kliment/reup/board.png

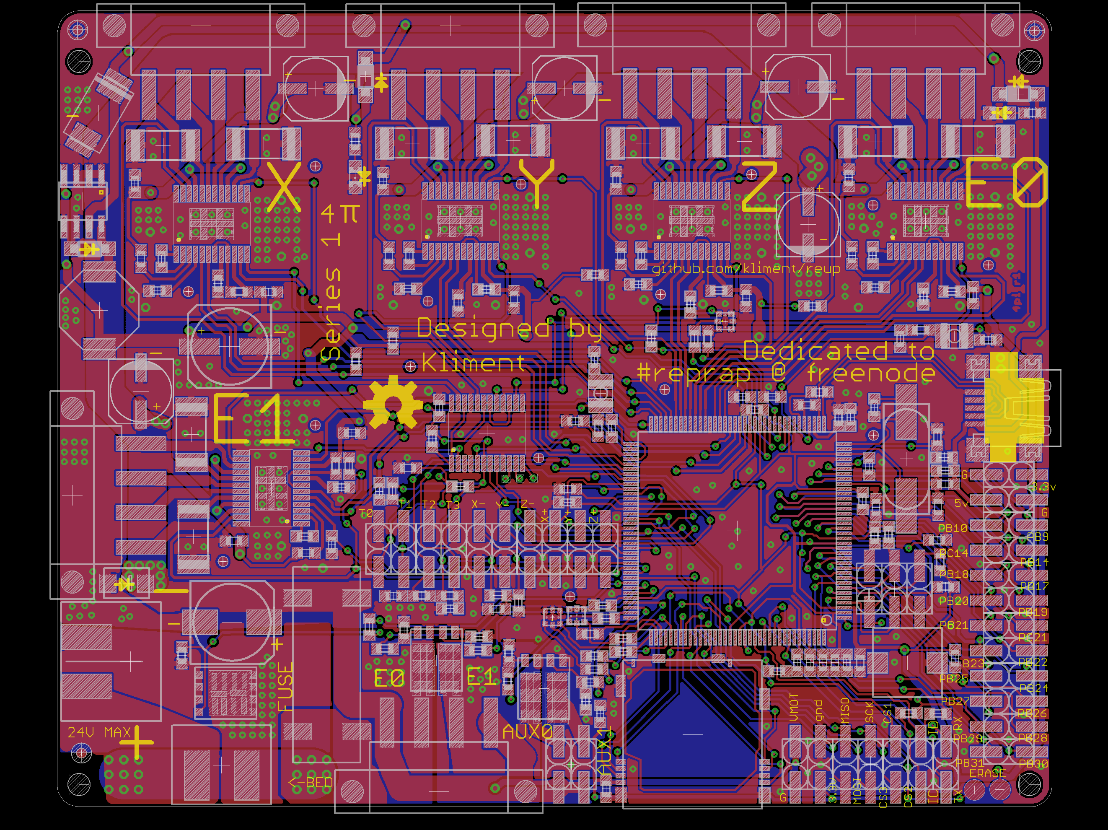
board.png
