kliment/reup/11862_V04_PB.xls

Sheet: Sheet1
Line item | Count | Value | Parts | Package | Substitution | Notes | Mouser URL | Digikey URL | Weco URL | Analog URL | Legend:
1 | 10 | 0.05r | R5 R6 R14 R15 R19 R20 R24 R25 R29 R30 | R2512 | SC | 2W, 1% | http://de.mouser.com/ProductDetail/Ohmite/MCS3264R050FER/ |  |  |  | DNS | Do not substitute
2 | 5 | 0R | R7 R16 R21 R26 R31 | R0603 | SA |  | https://de.mouser.com/Search/ProductDetail.aspx |  |  |  | SA | Substitute any with same value/package
3 | 15 | 100k | R9 R10 R12 R13 R18 R23 R28 R33 R39 R40 R41 R42 R43 R44 R65 | R0603 | SA |  | https://de.mouser.com/Search/ProductDetail.aspx |  |  |  | SC | Substitute any with same value/package and see notes
4 | 32 | 100n |  | C0603K | SC | >=35V | https://de.mouser.com/Search/ProductDetail.aspx |  |  |  | NP | Not populated
5 | 1 | 100uH | U$31 | INDUCTOR | SC | 100uH, 1A DC current | https://de.mouser.com/Search/ProductDetail.aspx
6 | 5 | 100u | C4 C14 C20 C26 C32 | UD-6,3X7,7_NICHICON | SC | >=35V | http://de.mouser.com/Search/ProductDetail.aspx
7 | 1 | 10k |  | R0603 | NP |  | https://de.mouser.com/Search/ProductDetail.aspx?R=301-10K-RCvirtualkey21980000virtualkey301-10K-RC
8 | 1 | 10n | C9 | C0603K | SA |  | http://de.mouser.com/Search/ProductDetail.aspx
9 | 3 | 10p | C37 C38 C65 | C0603K | SA |  | https://de.mouser.com/Search/ProductDetail.aspx
10 | 2 | 10uH | L1 L2 | L2825P | SC | 10uH, 600mA DC | http://de.mouser.com/Search/ProductDetail.aspx?R=36502A10virtualkey20420000virtualkey279-36502A10
11 | 9 | 10u | C39 C40 C41 C42 C57 C58 C63 C66 C67 | C0603K | SC | >=6V | https://de.mouser.com/Search/ProductDetail.aspx
12 | 1 | 120uf | C55 | 153CLV-0807 | SC | ESR <=28mOhm | http://de.mouser.com/Search/ProductDetail.aspx
13 | 11 | 1k | R47 R48 R49 R50 R51 R52 R53 R54 R55 R56 R58 | R0603 | SA |  | https://de.mouser.com/Search/ProductDetail.aspx?R=301-1.0K-RCvirtualkey21980000virtualkey301-1.0K-RC
14 | 3 | 1N5819HW | D1 D2 D3 | SOD123 | SC | 40v, 1a | https://de.mouser.com/Search/ProductDetail.aspx
15 | 2 | 1r | R45 R46 | R0603 | SA |  | https://de.mouser.com/Search/ProductDetail.aspx
16 | 2 | 20p | C35 C36 | C0603K | SA |  | http://de.mouser.com/Search/ProductDetail.aspx
17 | 6 | 210-A-126-SMD/04-PCP |  | 210-A-126-SMD-4 | DNS |  |  |  | http://www.weco.ca/product.php?id=586
18 | 10 | 220n | C5 C6 C15 C16 C21 C22 C27 C28 C33 C34 | C0603K | SC | >=35V | https://de.mouser.com/Search/ProductDetail.aspx
19 | 4 | 220r | R51 R60 R61 R62 | R0603 | SA |  | https://de.mouser.com/Search/ProductDetail.aspx
20 | 7 | 33k | R1 R2 R3 R4 R8 R11 R63 | R0603 | SC | 1.00% | https://de.mouser.com/Search/ProductDetail.aspx
21 | 2 | 39R | R34 R35 | R0603 | SC | 1.00% | https://de.mouser.com/Search/ProductDetail.aspx
22 | 7 | 4.7k | R17 R22 R27 R32 R57 R64 R66 | R0603 | SA |  | https://de.mouser.com/Search/ProductDetail.aspx
23 | 1 | 47k | R37 | R0603 | SC | 1.00% | https://de.mouser.com/Search/ProductDetail.aspx
24 | 4 | 4.7u | C10 C56 C59 C64 | C0603K | SC | >=6V | https://de.mouser.com/Search/ProductDetail.aspx
25 | 1 | 47u | C54 | D/7343-31R | SC | 35V, <=0.6Ohm ESR, 10% | https://de.mouser.com/Search/ProductDetail.aspx
26 | 1 | 6.8k | R36 | R0603 | SC | 1.00% | https://de.mouser.com/Search/ProductDetail.aspx
27 | 1 | 68k | R38 | R0603 | SC | 1.00% | https://de.mouser.com/Search/ProductDetail.aspx
28 | 1 | 974-D-SMD/02-TR |  | 974-D-SMD/02 | DNS |  |  |  | http://www.weco.ca/product.php?id=657
29 | 1 | 950-D-SMD/02-TR |  | 950-D-SMD/02 | DNS |  |  |  | http://www.weco.ca/product.php?id=658
30 | 5 | A4982 | U$5 U$7 U$9 U$11 U$13 | ETSSOP24 | DNS |  |  | http://search.digikey.com/de/en/products/A4982SLPTR-T/620-1352-1-ND/2295513
31 | 1 | AD5206 | U$16 | TSSOP24 | DNS |  |  |  |  | http://www.analog.com/en/digital-to-analog-converters/digital-potentiometers/ad5206/products/product.html
32 | 1 | BUTTON | U$27 | BUTTON | SC | Same footprint | https://de.mouser.com/Search/ProductDetail.aspx
33 | 2 | CHIPLED_0805 | LED1 LED4 | LED0603 | SA |  | https://de.mouser.com/Search/ProductDetail.aspx
34 | 1 | CSM-7X-DU |  | HC-49/S | SC | 10ppm, HC-49/S case | https://de.mouser.com/Search/ProductDetail.aspx
35 | 1 | FM4004 |  | SMX | SC | 1A 400V 30A surge | https://de.mouser.com/Search/ProductDetail.aspx?R=FM4004-Wvirtualkey58300000virtualkey583-FM4004
36 | 1 | FUSE |  | FUSEHOLDER | DNS |  | https://de.mouser.com/Search/ProductDetail.aspx?R=3587virtualkey53400000virtualkey534-3587
37 | 2 | IPG20N04S4L-11 |  | SUPERSO8 | DNS |  | https://de.mouser.com/Search/ProductDetail.aspx
38 | 1 | CSD17301Q5A |  | PQFNFET | DNS |  | http://de.mouser.com/Search/ProductDetail.aspx
39 | 1 | LM2594 |  | SO08 | DNS |  | https://de.mouser.com/Search/ProductDetail.aspx
40 | 3 | RGBLED |  | RGBLED | DNS |  | https://de.mouser.com/Search/ProductDetail.aspx
41 | 1 | SAM3U4E |  | LQFP144 | DNS |  | https://de.mouser.com/Search/ProductDetail.aspx
42 | 1 | SDCARD |  | SDCARD | DNS |  | https://de.mouser.com/Search/ProductDetail.aspx
43 | 2 | SMD.1 |  | SMD0.1x4 | SC | same or smaller external dimensions | https://de.mouser.com/Search/ProductDetail.aspx
44 | 2 | SMD.1X20 |  | SMD0.1X20 | SC | same or smaller external dimensions | https://de.mouser.com/Search/ProductDetail.aspx
45 | 1 | SMD.1X6 |  | SMD0.1X14 | SC | same or smaller external dimensions | https://de.mouser.com/Search/ProductDetail.aspx
46 | 1 | USBC |  | untitled | SC | Note pin order | https://de.mouser.com/Search/ProductDetail.aspx
47 | 1 | 220uF |  | 8x10.2 | SC | 50V, <0.2Ohm ESR | http://de.mouser.com/ProductDetail/Panasonic-Electronic-Components/EEE-FT1H221AP/

Sheet: V02_CH
Item | Count | Value | Parts | Package | Substitution | Notes | Mfg_CH | Mfg P/N_CH | Qty50 | Qty100 | Qty150 | $50 | $100 | $150 | Available | MOQ | Comment | Legend:
1 | 10 | 0.05r | R5 R6 R14 R15 R19 R20 R24 R25 R29 R30 | R2512 | SC | 2W, 1% | Ohmite | MCS3264R050FER | 500 | 1000 | 1500 | 0.300 | 0.280 | 0.280 | 1999 | 1 |  | DNS | Do not substitute
2 | 5 | 0R | R7 R16 R21 R26 R31 | R0603 | SA |  | KOA Speer | RK73Z1JTTD | 250 | 500 | 750 | 0.020 | 0.020 | 0.020 | 298038 | 1 |  | SA | Substitute any with same value/package
3 | 15 | 100k | R9 R10 R12 R13 R18 R23 R28 R33 R39 R40 R41 R42 R43 R44 R65 | R0603 | SA |  | Panasonic | ERJ-3EKF1003V | 750 | 1500 | 2250 | 0.005 | 0.003 | 0.002 | 133939 | 1 |  | SC | Substitute any with same value/package and see notes
4 | 32 | 100n |  | C0603K | SC | >=35V | TDK | CGA3E2X7R1H104K | 1600 | 3200 | 4800 | 0.015 | 0.015 | 0.011 | 307750 | 1 | No reference designator | NP | Not populated
5 | 1 | 100uH | U$31 | INDUCTOR | SC | 100uH, 1A DC current | Bourns | SRU8043-101Y | 50 | 100 | 150 | 1.260 | 1.140 | 1.140 | 724 | 1 | Newark,mouser no stock
6 | 5 | 100u | C4 C14 C20 C26 C32 | UD-6,3X7,7_NICHICON | SC | >=35V | Nichicon | UCD1V101MCL6GS | 250 | 500 | 750 | 0.290 | 0.290 | 0.290 | 5218 | 1
7 | 1 | 10k |  | R0603 | NP |  | Xicon | 301-10K-RC | 50 | 100 | 150 | 0.030 | 0.020 | 0.020 | 401872 | 1 | No reference designator
8 | 1 | 10n | C9 | C0603K | SA |  | Kemet | C0603C103M5RACAUTO | 50 | 100 | 150 | 0.060 | 0.050 | 0.050 | 10742 | 1
9 | 3 | 10p | C37 C38 C65 | C0603K | SA |  | Kemet | C0603C100K5GACTU | 150 | 300 | 450 | 0.069 | 0.069 | 0.069 | 6454 | 1
10 | 2 | 10uH | L1 L2 | L2825P | SC | 10uH, 600mA DC | TE Connectivity | 36502A10 | 100 | 200 | 300 | 0.140 | 0.140 | 0.130 | 920 | 1
11 | 9 | 10u | C39 C40 C41 C42 C57 C58 C63 C66 C67 | C0603K | SC | >=6V | TDK | C1608X5R0J106MT | 450 | 900 | 1350 | 0.095 | 0.085 | 0.077 | 72053 | 1
12 | 1 | 120uf | C55 | 153CLV-0807 | SC | ESR <=28mOhm | Nichicon | PCS1C121MCL1GS | 50 | 100 | 150 | 1.360 | 1.100 | 1.100 | 294 | 1
13 | 11 | 1k | R47 R48 R49 R50 R51 R52 R53 R54 R55 R56 R58 | R0603 | SA |  | Xicon | 301-1.0K-RC | 550 | 1100 | 1650 | 0.020 | 0.013 | 0.013 | 38532 | 1
14 | 3 | 1N5819HW | D1 D2 D3 | SOD123 | SC | 40v, 1a | Diodes Inc. | 1N5819HW-7-F | 150 | 300 | 450 | 0.225 | 0.220 | 0.220 | 20701 | 1
15 | 2 | 1r | R45 R46 | R0603 | SA |  | Vishay/Dale | CRCW06031R00FNEB | 100 | 200 | 300 | 0.027 | 0.027 | 0.027 | 13672 | 1
16 | 2 | 20p | C35 C36 | C0603K | SA |  | Murata | GRM1885C1H200JA01D | 100 | 200 | 300 | 0.021 | 0.021 | 0.021 | 20301 | 1
17 | 6 | 210-A-126-SMD/04-PCP |  | 210-A-126-SMD-4 | DNS |  | WECO | 210-A-126-SMD | 300 | 600 | 900 |  |  |  |  |  | No reference designator
18 | 10 | 220n | C5 C6 C15 C16 C21 C22 C27 C28 C33 C34 | C0603K | SC | >=35V | TDK | C1608Y5V1H224ZT | 500 | 1000 | 1500 | 0.026 | 0.017 | 0.017 | 49625 | 1
19 | 4 | 220r | R51 R60 R61 R62 | R0603 | SA |  | Panasonic | ERJ-3EKF2200V | 200 | 400 | 600 | 0.010 | 0.007 | 0.005 | 85815
20 | 7 | 33k | R1 R2 R3 R4 R8 R11 R63 | R0603 | SC | 1.00% | Panasonic | ERJ-3EKF3302V | 350 | 700 | 1050 | 0.007 | 0.005 | 0.003 | 171,963 | 1
21 | 2 | 39R | R34 R35 | R0603 | SC | 1.00% | KOA Speer | RK73H1JTTD39R0F | 100 | 200 | 300 | 0.020 | 0.020 | 0.020 | 83,566 | 1
22 | 7 | 4.7k | R17 R22 R27 R32 R57 R64 R66 | R0603 | SA |  | Panasonic | ERJ-3EKF4701V | 350 | 700 | 1050 | 0.007 | 0.005 | 0.003 | 58,645 | 1
23 | 1 | 47k | R37 | R0603 | SC | 1.00% | Panasonic | ERJ-3EKF4702V | 50 | 100 | 150 | 0.015 | 0.010 | 0.010 | 98,671 | 1 | Please confirm the Mft P/N is ERJ-3EKF4702V?
24 | 4 | 4.7u | C10 C56 C59 C64 | C0603K | SC | >=6V | Kemet | C0603C475K9PACTU | 200 | 400 | 600 | 0.070 | 0.070 | 0.036 | 81,505 | 1
25 | 1 | 47u | C54 | D/7343-31R | SC | 35V, <=0.6Ohm ESR, 10% | Kemet | T491X476K035AT | 50 | 100 | 150 | 2.350 | 1.430 | 1.430 | 11,816 | 1
26 | 1 | 6.8k | R36 | R0603 | SC | 1.00% | Panasonic | ERJ-3EKF6801V | 50 | 100 | 150 | 0.015 | 0.010 | 0.010 | 19,576 | 1
27 | 1 | 68k | R38 | R0603 | SC | 1.00% | Vishay/Dale | CRCW060368K0FKEA | 50 | 100 | 150 | 0.040 | 0.025 | 0.025 | 9,604 | 1
28 | 1 | 974-D-SMD/02-TR |  | 974-D-SMD/02 | DNS |  | WECO | 974-D-SMD/02-TR | 50 | 100 | 150 |  |  |  |  |  | No reference designator
29 | 1 | 950-D-SMD/02-TR |  | 950-D-SMD/02 | DNS |  | WECO | 950-D-SMD/02-TR | 50 | 100 | 150 |  |  |  |  |  | No reference designator
30 | 5 | A4982 | U$5 U$7 U$9 U$11 U$13 | ETSSOP24 | DNS |  | Allegro Microsystems Inc | A4982SLPTR-T | 250 | 500 | 750 | 2.540 | 2.223 | 2.032 | 3,032 | 1
31 | 1 | AD5206 | U$16 | TSSOP24 | DNS |  | Analog Devices Inc | AD5206BN10 | 50 | 100 | 150 | 4.166 | 3.796 | 3.796 | 168 | 1 | Can we use digikey P/N AD5206BN10?
32 | 1 | BUTTON | U$27 | BUTTON | SC | Same footprint | Omron | B3AL-1003P | 50 | 100 | 150 | 1.600 | 1.440 | 1.440 | 1,242 | 1
33 | 2 | CHIPLED_0805 | LED1 LED4 | LED0603 | SA |  | Dialight | 598-8120-107F | 100 | 200 | 300 | 0.061 | 0.061 | 0.050 | 21,345 | 1
34 | 1 | CSM-7X-DU |  | HC-49/S | SC | 10ppm, HC-49/S case | TXC Corporation | 9C-12.000MEEJ-T | 50 | 100 | 150 | 0.510 | 0.400 | 0.400 | 318 | 1 | No reference designator
35 | 1 | FM4004 |  | SMX | SC | 1A 400V 30A surge | Rectron | FM4004-W | 50 | 100 | 150 | 0.250 | 0.170 | 0.170 | 19,896 | 1 | No reference designator
36 | 1 | FUSE |  | FUSEHOLDER | DNS |  | Keystone Electronics | 3587 | 50 | 100 | 150 | 0.880 | 0.760 | 0.760 | 325 | 1 | No reference designator
37 | 2 | IPG20N04S4L-11 |  | SUPERSO8 | DNS |  | Infineon Technologies | IPG20N04S4L-11 | 100 | 200 | 300 | 0.600 | 0.600 | 0.600 | 4,865 | 1 | No reference designator
38 | 1 | CSD17301Q5A |  | PQFNFET | DNS |  | Texas Instruments | CSD17301Q5A | 50 | 100 | 150 | 1.420 | 1.290 | 1.290 | 4,481 | 1 | No reference designator
39 | 1 | LM2594 |  | SO08 | DNS |  | National Semiconductor | LM2594M-3.3/NOPB | 50 | 100 | 150 | 2.740 | 2.500 | 2.500 | 362 | 1 | No reference designator
40 | 3 | RGBLED |  | RGBLED | DNS |  | Osram Opto Semiconductor | LRTBR98G-R7T5-1+S7U-37+P7 | 150 | 300 | 450 | 0.535 | 0.535 | 0.535 | 8,678 | 1 | No reference designator
41 | 1 | SAM3U4E |  | LQFP144 | DNS |  | Atmel | ATSAM3U4EA-AU | 50 | 100 | 150 | 10.140 | 9.890 | 9.890 | 223 | 1 | No reference designator
42 | 1 | SDCARD |  | SDCARD | DNS |  | ALPS | SCHA5B0200 | 50 | 100 | 150 | 1.230 | 1.190 | 1.190 | 680 | 1 | No reference designator
43 | 2 | SMD.1 |  | SMD0.1x4 | SC | same or smaller external dimensions | FCI | 95278-101A04LF | 100 | 200 | 300 | 0.564 | 0.564 | 0.530 | 982 | 1 | No reference designator
44 | 2 | SMD.1X20 |  | SMD0.1X20 | SC | same or smaller external dimensions | FCI | 95278-101A20LF | 100 | 200 | 300 | 1.010 | 1.010 | 0.929 | 356 | 1 | No reference designator
45 | 1 | SMD.1X6 |  | SMD0.1X14 | SC | same or smaller external dimensions | FCI | 95278-101A14LF | 50 | 100 | 150 | 0.920 | 0.785 | 0.785 | 651 | 1 | No reference designator
46 | 1 | USBC |  | untitled | SC | Note pin order | Hirose Connector | UX60A-MB-5ST | 50 | 100 | 150 | 0.900 | 0.735 | 0.735 | 14,080 | 1 | No reference designator
47 | 1 | 220uF |  | 8x10.2 | SC | 50V, <0.2Ohm ESR | Panasonic | EEE-FT1H221AP | 50 | 100 | 150 | 0.746 | 0.589 | 0.589 | 1,813 | 1 | No reference designator

Sheet: V02_PB
Item | Count | Value | Parts | Package | Substitution | Notes | Mfg_CH | Mfg P/N_CH | Qty50 | Qty100 | Qty150 | $50 | $100 | $150 | Available | MOQ | Comment_PB | Prabal's Comment | Your Comment | Vendor | Legend: |  | tot_50 | tot_100 | tot_150
1 | 10 | 0.05r | R5 R6 R14 R15 R19 R20 R24 R25 R29 R30 | R2512 | SC | 2W, 1% | Ohmite | MCS3264R050FER | 500 | 1000 | 1500 | 0.300 | 0.280 | 0.280 | 1999 | 1 |  |  |  |  | DNS | Do not substitute | 3 | 2.8 | 2.8
2 | 5 | 0R | R7 R16 R21 R26 R31 | R0603 | SA |  | KOA Speer | RK73Z1JTTD | 250 | 500 | 750 | 0.020 | 0.020 | 0.020 | 298038 | 1 |  |  |  |  | SA | Substitute any with same value/package | 0.1 | 0.1 | 0.1
3 | 15 | 100k | R9 R10 R12 R13 R18 R23 R28 R33 R39 R40 R41 R42 R43 R44 R65 | R0603 | SA |  | Panasonic | ERJ-3EKF1003V | 750 | 1500 | 2250 | 0.005 | 0.003 | 0.002 | 133939 | 1 |  |  |  |  | SC | Substitute any with same value/package and see notes | 0.075 | 0.045 | 0.03
4 | 32 | 100n |  | C0603K | SC | >=35V | TDK | CGA3E2X7R1H104K | 1600 | 3200 | 4800 | 0.015 | 0.015 | 0.011 | 307750 | 1 |  |  |  |  | NP | Not populated | 0.48 | 0.48 | 0.352
5 | 1 | 100uH | U$31 | INDUCTOR | SC | 100uH, 1A DC current | Bourns | SRU8043-101Y | 50 | 100 | 150 | 1.260 | 1.140 | 1.140 | 724 | 1 |  |  |  | Newark |  |  | 1.26 | 1.14 | 1.14
6 | 5 | 100u | C4 C14 C20 C26 C32 | UD-6,3X7,7_NICHICON | SC | >=35V | Nichicon | UCD1V101MCL6GS | 250 | 500 | 750 | 0.290 | 0.290 | 0.290 | 5218 | 1 |  |  |  |  |  |  | 1.45 | 1.45 | 1.45
7 | 1 | 10k |  | R0603 | NP |  | Xicon | 301-10K-RC | 50 | 100 | 150 | 0.030 | 0.020 | 0.020 | 401872 | 1 | DNI |  |  |  |  |  | 0 | 0 | 0
8 | 1 | 10n | C9 | C0603K | SA |  | Kemet | C0603C103M5RACAUTO | 50 | 100 | 150 | 0.060 | 0.050 | 0.050 | 10742 | 1 |  |  |  |  |  |  | 0.06 | 0.05 | 0.05
9 | 3 | 10p | C37 C38 C65 | C0603K | SA |  | Kemet | C0603C100K5GACTU | 150 | 300 | 450 | 0.069 | 0.069 | 0.069 | 6454 | 1 |  |  |  |  |  |  | 0.207 | 0.207 | 0.207
10 | 2 | 10uH | L1 L2 | L2825P | SC | 10uH, 600mA DC | TE Connectivity | 36502A10 | 100 | 200 | 300 | 0.140 | 0.140 | 0.130 | 920 | 1 |  |  |  |  |  |  | 0.28 | 0.28 | 0.26
11 | 9 | 10u | C39 C40 C41 C42 C57 C58 C63 C66 C67 | C0603K | SC | >=6V | TDK | C1608X5R0J106MT | 450 | 900 | 1350 | 0.095 | 0.085 | 0.077 | 72053 | 1 |  |  |  |  |  |  | 0.855 | 0.765 | 0.693
12 | 1 | 120uf | C55 | 153CLV-0807 | SC | ESR <=28mOhm | Nichicon | PCS1C121MCL1GS | 50 | 100 | 150 | 1.360 | 1.100 | 1.100 | 294 | 1 |  |  |  |  |  |  | 1.36 | 1.1 | 1.1
13 | 11 | 1k | R47 R48 R49 R50 R51 R52 R53 R54 R55 R56 R58 | R0603 | SA |  | Xicon | 301-1.0K-RC | 550 | 1100 | 1650 | 0.020 | 0.013 | 0.013 | 38532 | 1 |  |  |  |  |  |  | 0.22 | 0.143 | 0.143
14 | 3 | 1N5819HW | D1 D2 D3 | SOD123 | SC | 40v, 1a | Diodes Inc. | 1N5819HW-7-F | 150 | 300 | 450 | 0.225 | 0.220 | 0.220 | 20701 | 1 |  |  |  |  |  |  | 0.675 | 0.66 | 0.66
15 | 2 | 1r | R45 R46 | R0603 | SA |  | Vishay/Dale | CRCW06031R00FNEB | 100 | 200 | 300 | 0.027 | 0.027 | 0.027 | 13672 | 1 |  |  |  |  |  |  | 0.054 | 0.054 | 0.054
16 | 2 | 20p | C35 C36 | C0603K | SA |  | Murata | GRM1885C1H200JA01D | 100 | 200 | 300 | 0.021 | 0.021 | 0.021 | 20301 | 1 |  |  |  |  |  |  | 0.042 | 0.042 | 0.042
17 | 6 | 210-A-126-SMD/04-PCP |  | 210-A-126-SMD-4 | DNS |  | WECO | 210-A-126-SMD | 300 | 600 | 900 |  |  |  |  |  | Mfg P/N "210-A-126-SMD/04-PCP" does not match at major suppliers. Have your comment. |  |  |  |  |  | 0 | 0 | 0
18 | 10 | 220n | C5 C6 C15 C16 C21 C22 C27 C28 C33 C34 | C0603K | SC | >=35V | TDK | C1608Y5V1H224ZT | 500 | 1000 | 1500 | 0.026 | 0.017 | 0.017 | 49625 | 1 |  |  |  |  |  |  | 0.26 | 0.17 | 0.17
19 | 4 | 220r | R51 R60 R61 R62 | R0603 | SA |  | Panasonic | ERJ-3EKF2200V | 200 | 400 | 600 | 0.010 | 0.007 | 0.005 | 85815 |  |  |  |  |  |  |  | 0.04 | 0.028 | 0.02
20 | 7 | 33k | R1 R2 R3 R4 R8 R11 R63 | R0603 | SC | 1.00% | Panasonic | ERJ-3EKF3302V | 350 | 700 | 1050 | 0.007 | 0.005 | 0.003 | 171,963 | 1 |  |  |  |  |  |  | 0.049 | 0.035 | 0.021
21 | 2 | 39R | R34 R35 | R0603 | SC | 1.00% | KOA Speer | RK73H1JTTD39R0F | 100 | 200 | 300 | 0.020 | 0.020 | 0.020 | 83,566 | 1 |  |  |  |  |  |  | 0.04 | 0.04 | 0.04
22 | 7 | 4.7k | R17 R22 R27 R32 R57 R64 R66 | R0603 | SA |  | Panasonic | ERJ-3EKF4701V | 350 | 700 | 1050 | 0.007 | 0.005 | 0.003 | 58,645 | 1 |  |  |  |  |  |  | 0.049 | 0.035 | 0.021
23 | 1 | 47k | R37 | R0603 | SC | 1.00% | Panasonic | ERJ-3EKF4702V | 50 | 100 | 150 | 0.015 | 0.010 | 0.010 | 98,671 | 1 | The provided link refers to Mft P/N as ERJ-3EKF4702V. Please confirm | Use Mft P/N ERJ-3EKF4702V |  |  |  |  | 0.015 | 0.01 | 0.01
24 | 4 | 4.7u | C10 C56 C59 C64 | C0603K | SC | >=6V | Kemet | C0603C475K9PACTU | 200 | 400 | 600 | 0.070 | 0.070 | 0.036 | 81,505 | 1 |  |  |  |  |  |  | 0.28 | 0.28 | 0.144
25 | 1 | 47u | C54 | D/7343-31R | SC | 35V, <=0.6Ohm ESR, 10% | Kemet | T491X476K035AT | 50 | 100 | 150 | 2.350 | 1.430 | 1.430 | 11,816 | 1 |  |  |  |  |  |  | 2.35 | 1.43 | 1.43
26 | 1 | 6.8k | R36 | R0603 | SC | 1.00% | Panasonic | ERJ-3EKF6801V | 50 | 100 | 150 | 0.015 | 0.010 | 0.010 | 19,576 | 1 |  |  |  |  |  |  | 0.015 | 0.01 | 0.01
27 | 1 | 68k | R38 | R0603 | SC | 1.00% | Vishay/Dale | CRCW060368K0FKEA | 50 | 100 | 150 | 0.040 | 0.025 | 0.025 | 9,604 | 1 |  |  |  |  |  |  | 0.04 | 0.025 | 0.025
28 | 1 | 974-D-SMD/02-TR |  | 974-D-SMD/02 | DNS |  | WECO | 974-D-SMD/02-TR | 50 | 100 | 150 |  |  |  |  |  | no parts were found at major distributors for P/N "974-D-SMD-DS" |  |  |  |  |  | 0 | 0 | 0
29 | 1 | 950-D-SMD/02-TR |  | 950-D-SMD/02 | DNS |  | WECO | 950-D-SMD/02-TR | 50 | 100 | 150 | 0.955 | 0.955 | 0.785 | 43 |  | The provided link refers to Mft P/N as 950-D-SMD-DS/02. Please confirm |  |  |  |  |  | 0.955 | 0.955 | 0.785
30 | 5 | A4982 | U$5 U$7 U$9 U$11 U$13 | ETSSOP24 | DNS |  | Allegro Microsystems Inc | A4982SLPTR-T | 250 | 500 | 750 | 2.540 | 2.223 | 2.032 | 3,032 | 1 |  |  |  |  |  |  | 12.7 | 11.1125 | 10.16
31 | 1 | AD5206 | U$16 | TSSOP24 | DNS |  | Analog Devices Inc | AD5206BN10 | 50 | 100 | 150 | 4.166 | 3.796 | 3.796 | 2,719 | 1 | "AD5206" refers to more than one unique part. Can we use digikey P/N AD5206BN10? |  |  |  |  |  | 4.1664 | 3.7961 | 3.7961
32 | 1 | BUTTON | U$27 | BUTTON | SC | Same footprint | Omron | B3AL-1003P | 50 | 100 | 150 | 1.600 | 1.440 | 1.440 | 1,242 | 1 |  |  |  |  |  |  | 1.6 | 1.44 | 1.44
33 | 2 | CHIPLED_0805 | LED1 LED4 | LED0603 | SA |  | Dialight | 598-8120-107F | 100 | 200 | 300 | 0.061 | 0.061 | 0.050 | 21,345 | 1 |  |  |  |  |  |  | 0.122 | 0.122 | 0.1
34 | 1 | CSM-7X-DU |  | HC-49/S | SC | 10ppm, HC-49/S case | TXC Corporation | 9C-12.000MEEJ-T | 50 | 100 | 150 | 0.510 | 0.400 | 0.400 | 318 | 1 |  |  |  |  |  |  | 0.51 | 0.4 | 0.4
35 | 1 | FM4004 |  | SMX | SC | 1A 400V 30A surge | Rectron | FM4004-W | 50 | 100 | 150 | 0.250 | 0.170 | 0.170 | 19,896 | 1 |  |  |  |  |  |  | 0.25 | 0.17 | 0.17
36 | 1 | FUSE |  | FUSEHOLDER | DNS |  | Keystone Electronics | 3587 | 50 | 100 | 150 | 0.880 | 0.760 | 0.760 | 325 | 1 |  |  |  |  |  |  | 0.88 | 0.76 | 0.76
37 | 2 | IPG20N04S4L-11 |  | SUPERSO8 | DNS |  | Infineon Technologies | IPG20N04S4L-11 | 100 | 200 | 300 | 0.600 | 0.600 | 0.600 | 4,865 | 1 |  |  |  |  |  |  | 1.2 | 1.2 | 1.2
38 | 1 | CSD17301Q5A |  | PQFNFET | DNS |  | Texas Instruments | CSD17301Q5A | 50 | 100 | 150 | 1.420 | 1.290 | 1.290 | 4,481 | 1 |  |  |  |  |  |  | 1.42 | 1.29 | 1.29
39 | 1 | LM2594 |  | SO08 | DNS |  | National Semiconductor | LM2594M-3.3/NOPB | 50 | 100 | 150 | 2.740 | 2.500 | 2.500 | 362 | 1 |  |  |  |  |  |  | 2.74 | 2.5 | 2.5
40 | 3 | RGBLED |  | RGBLED | DNS |  | Osram Opto Semiconductor | LRTBR98G-R7T5-1+S7U-37+P7 | 150 | 300 | 450 | 0.535 | 0.535 | 0.535 | 8,678 | 1 |  |  |  |  |  |  | 1.605 | 1.605 | 1.605
41 | 1 | SAM3U4E |  | LQFP144 | DNS |  | Atmel | ATSAM3U4EA-AU | 50 | 100 | 150 | 10.140 | 9.890 | 9.890 | 223 | 1 |  |  |  |  |  |  | 10.14 | 9.89 | 9.89
42 | 1 | SDCARD |  | SDCARD | DNS |  | ALPS | SCHA5B0200 | 50 | 100 | 150 | 1.230 | 1.190 | 1.190 | 680 | 1 |  |  |  |  |  |  | 1.23 | 1.19 | 1.19
43 | 2 | SMD.1 |  | SMD0.1x4 | SC | same or smaller external dimensions | FCI | 95278-101A04LF | 100 | 200 | 300 | 0.564 | 0.564 | 0.530 | 982 | 1 |  |  |  |  |  |  | 1.128 | 1.128 | 1.06
44 | 2 | SMD.1X20 |  | SMD0.1X20 | SC | same or smaller external dimensions | FCI | 95278-101A20LF | 100 | 200 | 300 | 1.010 | 1.010 | 0.929 | 356 | 1 |  |  |  |  |  |  | 2.02 | 2.02 | 1.858
45 | 1 | SMD.1X6 |  | SMD0.1X14 | SC | same or smaller external dimensions | FCI | 95278-101A14LF | 50 | 100 | 150 | 0.920 | 0.785 | 0.785 | 651 | 1 |  |  |  |  |  |  | 0.92 | 0.785 | 0.785
46 | 1 | USBC |  | untitled | SC | Note pin order | Hirose Connector | UX60A-MB-5ST | 50 | 100 | 150 | 0.900 | 0.735 | 0.735 | 14,080 | 1 |  |  |  |  |  |  | 0.9 | 0.735 | 0.735
47 | 1 | 220uF |  | 8x10.2 | SC | 50V, <0.2Ohm ESR | Panasonic | EEE-FT1H221AP | 50 | 100 | 150 | 0.746 | 0.589 | 0.589 | 1,813 | 1 |  |  |  |  |  |  | 0.746 | 0.589 | 0.589
 |  |  |  |  |  |  |  |  |  |  |  |  |  |  |  |  |  |  |  |  |  |  | 58.4884 | 53.0666 | 51.2851
 |  |  |  |  |  |  |  |  |  |  |  |  |  |  |  |  |  |  |  |  |  |  | 2.92442 | 2.65333 | 2.564255

Sheet: V04_PB
Item | Count | Value | Parts | Package | Substitution | Notes | Mfg_CH | Mfg P/N_CH | Qty50 | Qty100 | Qty150 | $50 | $100 | $150 | Available | MOQ | Bittele Comment | Your Comment | Vendor | Legend: | tot_50 | tot_100 | tot_150
1 | 10 | 0.05r | R5 R6 R14 R15 R19 R20 R24 R25 R29 R30 | R2512 | SC | 2W, 1% | Ohmite | MCS3264R050FER | 500 | 1000 | 1500 | 0.300 | 0.280 | 0.280 | 1999 | 1 |  |  |  |  | 3 | 2.8 | 2.8
2 | 5 | 0R | R7 R16 R21 R26 R31 | R0603 | SA |  | KOA Speer | RK73Z1JTTD | 250 | 500 | 750 | 0.020 | 0.020 | 0.020 | 298038 | 1 |  |  |  |  | 0.1 | 0.1 | 0.1
3 | 15 | 100k | R9 R10 R12 R13 R18 R23 R28 R33 R39 R40 R41 R42 R43 R44 R65 | R0603 | SA |  | Panasonic | ERJ-3EKF1003V | 750 | 1500 | 2250 | 0.005 | 0.003 | 0.002 | 133939 | 1 |  |  |  |  | 0.075 | 0.045 | 0.03
4 | 32 | 100n | C1 C2 C3 C7 C8 C11 C12 C13 C17 C18 C19 C23 C24 C25 C29 C30 C31 C43 C44 C45 C46 C47 C48 C49 C50 C51 C52 C53 C60 C61 C62 C68 | C0603K | SC | >=35V | TDK | CGA3E2X7R1H104K | 1600 | 3200 | 4800 | 0.015 | 0.015 | 0.011 | 307750 | 1 |  |  |  |  | 0.48 | 0.48 | 0.352
5 | 1 | 100uH | U$31 | INDUCTOR | SC | 100uH, 1A DC current | Bourns | SRU8043-101Y | 50 | 100 | 150 | 1.260 | 1.140 | 1.140 | 724 | 1 |  |  | http://de.mouser.com/Search/ProductDetail.aspx |  | 1.26 | 1.14 | 1.14
6 | 5 | 100u | C4 C14 C20 C26 C32 | UD-6,3X7,7_NICHICON | SC | >=35V | Nichicon | UCD1V101MCL6GS | 250 | 500 | 750 | 0.290 | 0.290 | 0.290 | 5218 | 1 |  |  |  |  | 1.45 | 1.45 | 1.45
7 | 1 | 10n | C9 | C0603K | SA |  | Kemet | C0603C103M5RACAUTO | 50 | 100 | 150 | 0.060 | 0.050 | 0.050 | 10742 | 1 |  |  |  |  | 0.06 | 0.05 | 0.05
8 | 3 | 10p | C37 C38 C65 | C0603K | SA |  | Kemet | C0603C100K5GACTU | 150 | 300 | 450 | 0.069 | 0.069 | 0.069 | 6454 | 1 |  |  |  |  | 0.207 | 0.207 | 0.207
9 | 2 | 10uH | L1 L2 | L2825P | SC | 10uH, 600mA DC | TE Connectivity | 36502A10 | 100 | 200 | 300 | 0.140 | 0.140 | 0.130 | 920 | 1 |  |  |  |  | 0.28 | 0.28 | 0.26
10 | 9 | 10u | C39 C40 C41 C42 C57 C58 C63 C66 C67 | C0603K | SC | >=6V | TDK | C1608X5R0J106MT | 450 | 900 | 1350 | 0.095 | 0.085 | 0.077 | 72053 | 1 |  |  |  |  | 0.855 | 0.765 | 0.693
11 | 1 | 120uf | C55 | 153CLV-0807 | SC | ESR <=28mOhm | Nichicon | PCS1C121MCL1GS | 50 | 100 | 150 | 1.360 | 1.100 | 1.100 | 294 | 1 |  |  |  |  | 1.36 | 1.1 | 1.1
12 | 11 | 1k | R47 R48 R49 R50 R51 R52 R53 R54 R55 R56 R58 | R0603 | SA |  | Xicon | 301-1.0K-RC | 550 | 1100 | 1650 | 0.020 | 0.013 | 0.013 | 38532 | 1 |  |  |  |  | 0.22 | 0.143 | 0.143
13 | 3 | 1N5819HW | D1 D2 D3 | SOD123 | SC | 40v, 1a | Diodes Inc. | 1N5819HW-7-F | 150 | 300 | 450 | 0.225 | 0.220 | 0.220 | 20701 | 1 |  |  |  |  | 0.675 | 0.66 | 0.66
14 | 2 | 1r | R45 R46 | R0603 | SA |  | Vishay/Dale | CRCW06031R00FNEB | 100 | 200 | 300 | 0.027 | 0.027 | 0.027 | 13672 | 1 |  |  |  |  | 0.054 | 0.054 | 0.054
15 | 2 | 20p | C35 C36 | C0603K | SA |  | Murata | GRM1885C1H200JA01D | 100 | 200 | 300 | 0.021 | 0.021 | 0.021 | 20301 | 1 |  |  |  |  | 0.042 | 0.042 | 0.042
16 | 6 | 210-A-126-SMD/04-PCP | U$6 U$10 U$12 U$14 U$15 U$19 | 210-A-126-SMD-4 | DNS |  | WECO | 210-A-126-SMD | 300 | 600 | 900 | 2.250 | 2.250 | 2.250 |  | 250 | Lead time is 8-10 weeks. The min is 250pcs. |  | Weco Germany |  | 13.5 | 13.5 | 13.5
17 | 10 | 220n | C5 C6 C15 C16 C21 C22 C27 C28 C33 C34 | C0603K | SC | >=35V | TDK | C1608Y5V1H224ZT | 500 | 1000 | 1500 | 0.026 | 0.017 | 0.017 | 49625 | 1 |  |  |  |  | 0.26 | 0.17 | 0.17
18 | 4 | 220r | R51 R60 R61 R62 | R0603 | SA |  | Panasonic | ERJ-3EKF2200V | 200 | 400 | 600 | 0.010 | 0.007 | 0.005 | 85815 |  |  |  |  |  | 0.04 | 0.028 | 0.02
19 | 7 | 33k | R1 R2 R3 R4 R8 R63 | R0603 | SC | 1.00% | Panasonic | ERJ-3EKF3302V | 350 | 700 | 1050 | 0.007 | 0.005 | 0.003 | 171,963 | 1 |  |  |  |  | 0.049 | 0.035 | 0.021
20 | 2 | 39R | R34 R35 | R0603 | SC | 1.00% | KOA Speer | RK73H1JTTD39R0F | 100 | 200 | 300 | 0.020 | 0.020 | 0.020 | 83,566 | 1 |  |  |  |  | 0.04 | 0.04 | 0.04
21 | 7 | 4.7k | R17 R22 R27 R32 R57 R64 R66 | R0603 | SA |  | Panasonic | ERJ-3EKF4701V | 350 | 700 | 1050 | 0.007 | 0.005 | 0.003 | 58,645 | 1 |  |  |  |  | 0.049 | 0.035 | 0.021
22 | 1 | 47k | R37 | R0603 | SC | 1.00% | Panasonic | ERJ-3EKF4702V | 50 | 100 | 150 | 0.015 | 0.010 | 0.010 | 98,671 | 1 | The provided link refers to Mft P/N as ERJ-3EKF4702V. Please confirm |  |  |  | 0.015 | 0.01 | 0.01
23 | 4 | 4.7u | C10 C56 C59 C64 | C0603K | SC | >=6V | Kemet | C0603C475K9PACTU | 200 | 400 | 600 | 0.070 | 0.070 | 0.036 | 81,505 | 1 |  |  |  |  | 0.28 | 0.28 | 0.144
24 | 1 | 47u | C54 | D/7343-31R | SC | 35V, <=0.6Ohm ESR, 10% | Kemet | T491X476K035AT | 50 | 100 | 150 | 2.350 | 1.430 | 1.430 | 11,816 | 1 |  |  |  |  | 2.35 | 1.43 | 1.43
25 | 2 | 6.8k | R36 R11 | R0603 | SC | 1.00% | Panasonic | ERJ-3EKF6801V | 100 | 200 | 300 | 0.015 | 0.010 | 0.010 | 19,576 | 1 |  |  |  |  | 0.03 | 0.02 | 0.02
26 | 1 | 68k | R38 | R0603 | SC | 1.00% | Vishay/Dale | CRCW060368K0FKEA | 50 | 100 | 150 | 0.040 | 0.025 | 0.025 | 9,604 | 1 |  |  |  |  | 0.04 | 0.025 | 0.025
27 | 1 | 974-D-SMD/02-TR | U$22 | 974-D-SMD/02 | DNS |  | WECO | 974-D-SMD/02-TR | 50 | 100 | 150 | 4.250 | 2.125 | 1.417 |  | 250 | Lead time is 8-10 weeks. The price comes from min qty 250pcs. |  | Weco Germany |  | 4.25 | 2.125 | 1.416666667
28 | 1 | 950-D-SMD/02-TR | U$21 | 950-D-SMD/02 | DNS |  | WECO | 950-D-SMD/02-TR | 50 | 100 | 150 | 4.250 | 2.125 | 1.417 |  | 250 | Lead time is 8-10 weeks. The price comes from min qty 250pcs. |  | Weco Germany |  | 4.25 | 2.125 | 1.416666667
29 | 5 | A4982 | U$5 U$7 U$9 U$11 U$13 | ETSSOP24 | DNS |  | Allegro Microsystems Inc | A4982SLPTR-T | 250 | 500 | 750 | 2.540 | 2.223 | 2.032 | 3,032 | 1 |  |  |  |  | 12.7 | 11.1125 | 10.16
30 | 1 | AD5206 | U$16 | TSSOP24 | DNS |  | Analog Devices Inc | AD5206BRUZ10 | 50 | 100 | 150 | 4.166 | 3.796 | 3.796 | 168 | 1 | P/N "AD5206BRUZ10" was used for pricing |  |  |  | 4.1664 | 3.7961 | 3.7961
31 | 1 | BUTTON | U$27 | BUTTON | SC | Same footprint | Omron | B3AL-1003P | 50 | 100 | 150 | 1.600 | 1.440 | 1.440 | 1,242 | 1 |  |  |  |  | 1.6 | 1.44 | 1.44
32 | 2 | CHIPLED_0805 | LED1 LED4 | LED0603 | SA |  | Dialight | 598-8120-107F | 100 | 200 | 300 | 0.061 | 0.061 | 0.050 | 21,345 | 1 |  |  |  |  | 0.122 | 0.122 | 0.1
33 | 1 | CSM-7X-DU | Q1 | HC-49/S | SC | 10ppm, HC-49/S case | TXC Corporation | 9C-12.000MEEJ-T | 50 | 100 | 150 | 0.510 | 0.400 | 0.400 | 318 | 1 |  |  |  |  | 0.51 | 0.4 | 0.4
34 | 1 | FM4004 | U$32 | SMX | SC | 1A 400V 30A surge | Rectron | FM4004-W | 50 | 100 | 150 | 0.250 | 0.170 | 0.170 | 19,896 | 1 |  |  |  |  | 0.25 | 0.17 | 0.17
35 | 1 | FUSE | U$26 | FUSEHOLDER | DNS |  | Keystone Electronics | 3587 | 50 | 100 | 150 | 0.880 | 0.760 | 0.760 | 325 | 1 |  |  |  |  | 0.88 | 0.76 | 0.76
36 | 2 | IPG20N04S4L-11 | U$1 U$2 | SUPERSO8 | DNS |  | Infineon Technologies | IPG20N04S4L-11 | 100 | 200 | 300 | 0.600 | 0.600 | 0.600 | 4,865 | 1 |  |  |  |  | 1.2 | 1.2 | 1.2
37 | 1 | CSD17301Q5A | U$4 | PQFNFET | DNS |  | Texas Instruments | CSD17301Q5A | 50 | 100 | 150 | 1.420 | 1.290 | 1.290 | 4,481 | 1 |  |  |  |  | 1.42 | 1.29 | 1.29
38 | 1 | LM2594 | U$24 | SO08 | DNS |  | National Semiconductor | LM2594M-3.3/NOPB | 50 | 100 | 150 | 2.740 | 2.500 | 2.500 | 362 | 1 |  |  |  |  | 2.74 | 2.5 | 2.5
39 | 3 | RGBLED | U$33 U$34 U$35 | RGBLED | DNS |  | Osram Opto Semiconductor | LRTBR98G-R7T5-1+S7U-37+P7 | 150 | 300 | 450 | 0.535 | 0.535 | 0.535 | 8,678 | 1 |  |  |  |  | 1.605 | 1.605 | 1.605
40 | 1 | SAM3U4E | U$8 | LQFP144 | DNS |  | Atmel | ATSAM3U4EA-AU | 50 | 100 | 150 | 10.140 | 9.890 | 9.890 | 223 | 1 |  |  |  |  | 10.14 | 9.89 | 9.89
41 | 1 | SDCARD | U$25 | SDCARD | DNS |  | ALPS | SCHA5B0200 | 50 | 100 | 150 | 1.230 | 1.190 | 1.190 | 680 | 1 |  |  |  |  | 1.23 | 1.19 | 1.19
42 | 2 | SMD.1 | U$20 U$28 | SMD0.1x4 | SC | same or smaller external dimensions | FCI | 95278-101A04LF | 100 | 200 | 300 | 0.564 | 0.564 | 0.530 | 982 | 1 |  |  |  |  | 1.128 | 1.128 | 1.06
43 | 2 | SMD.1X20 | U$3 U$17 | SMD0.1X20 | SC | same or smaller external dimensions | FCI | 95278-101A20LF | 100 | 200 | 300 | 1.010 | 1.010 | 0.929 | 356 | 1 |  |  |  |  | 2.02 | 2.02 | 1.858
44 | 1 | SMD.1X6 | U$43 | SMD0.1X14 | SC | same or smaller external dimensions | FCI | 95278-101A14LF | 50 | 100 | 150 | 0.920 | 0.785 | 0.785 | 651 | 1 |  |  |  |  | 0.92 | 0.785 | 0.785
45 | 1 | USBC | X1 | untitled | SC | Note pin order | Hirose Connector | UX60A-MB-5ST | 50 | 100 | 150 | 0.900 | 0.735 | 0.735 | 14,080 | 1 |  |  |  |  | 0.9 | 0.735 | 0.735
46 | 1 | 220uF | U$36 | 8x10.2 | SC | 50V, <0.2Ohm ESR | Panasonic | EEE-FT1H221AP | 50 | 100 | 150 | 0.746 | 0.589 | 0.589 | 1,813 | 1 |  |  |  |  | 0.746 | 0.589 | 0.589
 |  |  |  |  |  |  |  |  |  |  |  |  |  |  |  |  |  |  |  |  | 79.5484 | 69.8716 | 66.84343333
 |  |  |  |  |  |  |  |  |  |  |  |  |  |  |  |  |  |  |  |  | 3.97742 | 3.49358 | 3.342171667
 |  |  |  |  |  |  |  |  |  |  |  |  |  |  |  |  |  |  |  |  | 3.3 | 1.65 | 1.1
 |  |  |  |  |  |  |  |  |  |  |  |  |  |  |  |  |  |  |  |  | 0 | 0 | 0
 |  |  |  |  |  |  |  |  |  |  |  |  |  |  |  |  |  |  |  |  | 86.82582 | 75.01518 | 71.285605
