kliment/reup/4pi-schematic.pdf

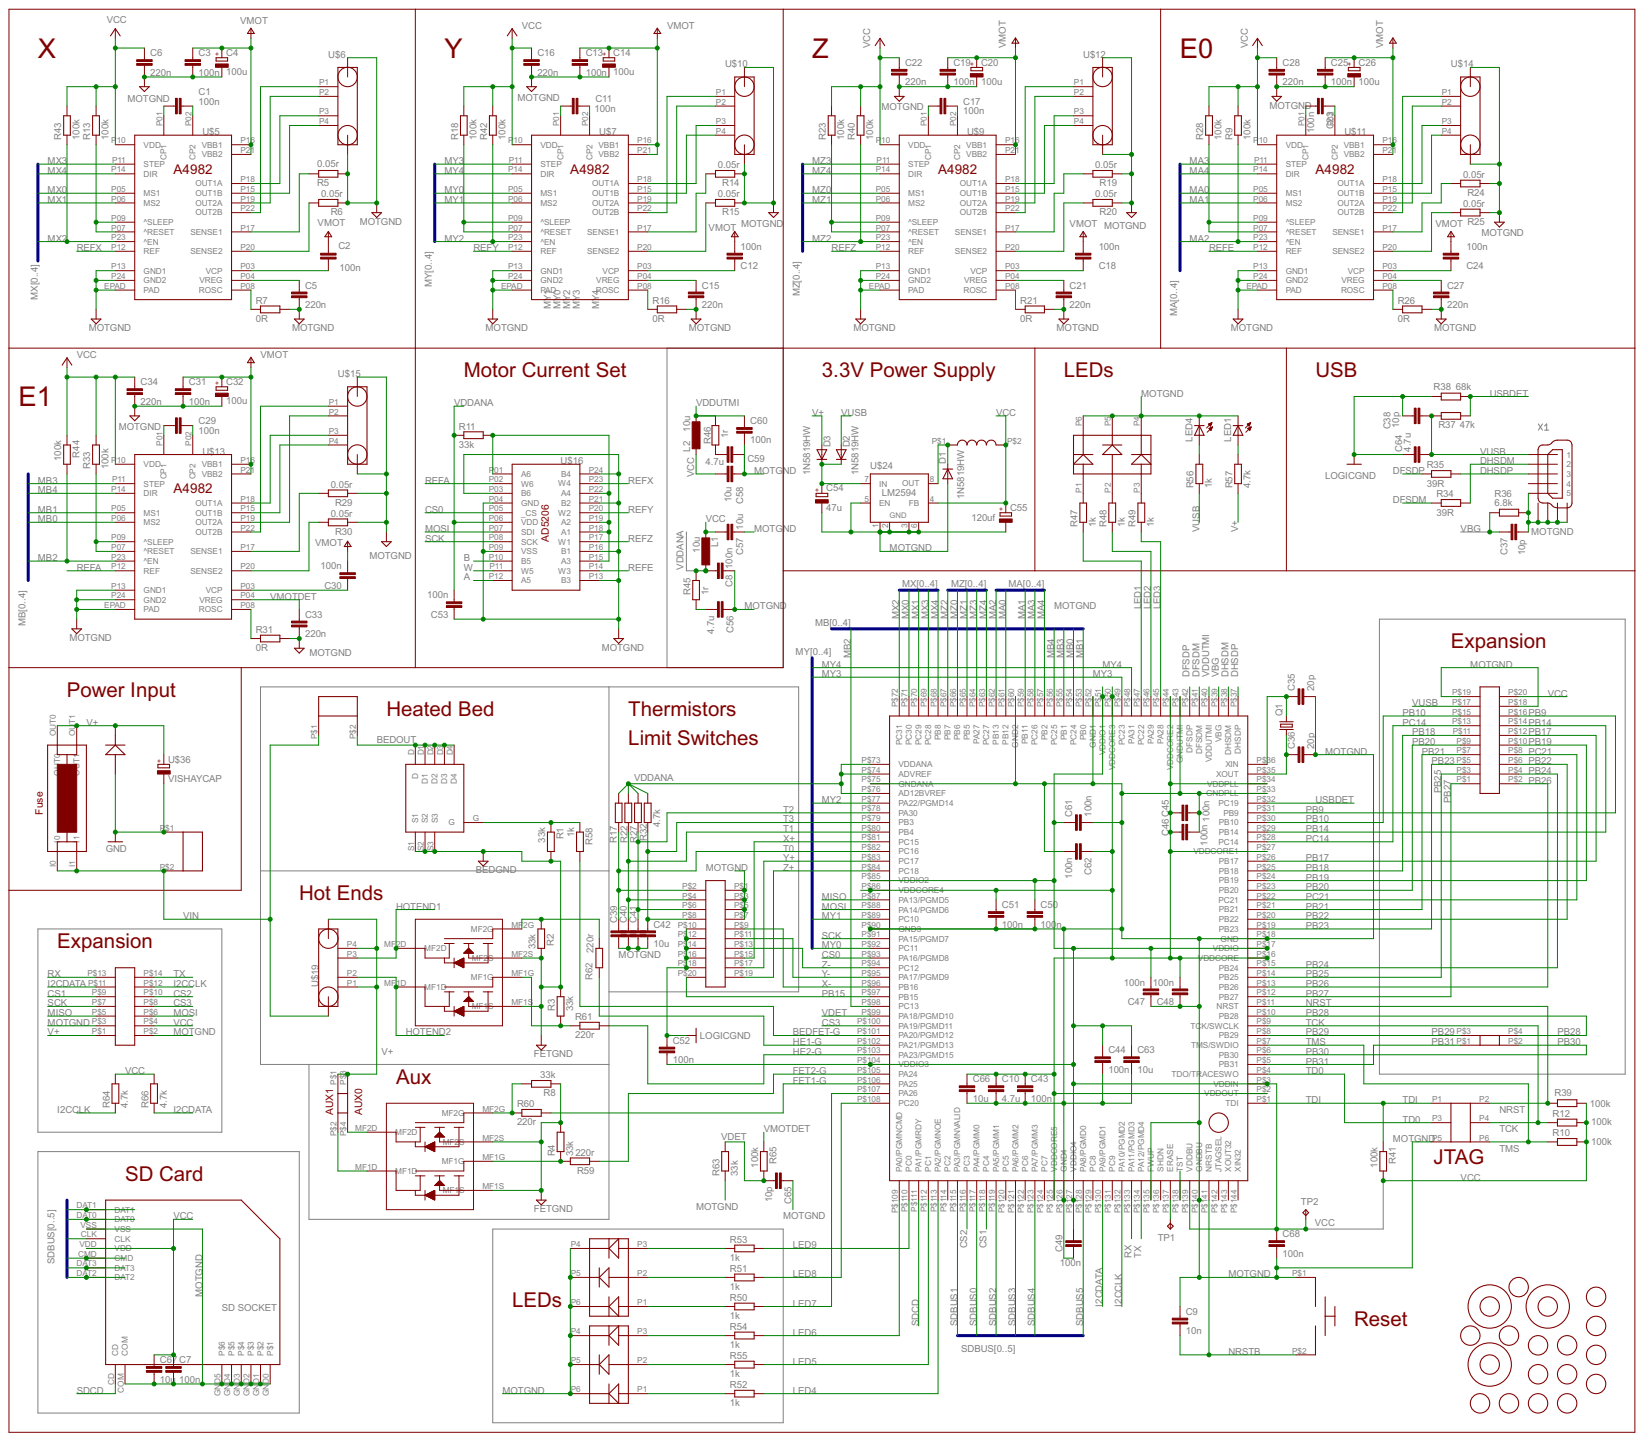
[picture p2: page 1]

Power Input

BEDOUT | Thermistors Limit Switches Heated Bed VDDANA

PB18 | PB17
PB20 | PB19
