kliment/reup/(commit log)

2011-10-06 Added initial 5 axis board layout
    [untitled.brd, untitled.sch]
2011-10-26 Added footprint for Weco SMD screw terminal.
2011-10-26 Improve thermal layout for stepper modules. Add sam3u chip and initial connections. Make microstepping software controlled. Increase +12v trace thickness for motors.
    [untitled.brd, untitled.sch]
2011-10-27 Copy stepper driver module, move cap on 4th driver, add MOTV+ routing
    [untitled.brd]
2011-10-27 Add pours, wire USB
    [untitled.brd, untitled.sch]
2011-10-30 Change package on processor
    [untitled.brd, untitled.sch]
2011-11-02 Added potentiometer. Routed most of the board. Fixed most DRC violations - board can be done with 8mil process
    [untitled.brd, untitled.sch]
2011-11-02 Add thermistor/endstop headers (not yet routed). Fix DRC violations.
    [untitled.brd, untitled.sch]
2011-11-02 Add several connectors. Move FETs around to make space.
    [untitled.brd, untitled.sch]
2011-11-04 Add SD, expansion header, thermistor passives, power connector, bed connector. Reroute USB to be high speed compatible. Add extra FET channel. Move hotends to a dual FET chip.
    [untitled.brd, untitled.sch]
2011-11-06 Route endstop and thermistor connector. Switch to different bed FET. Route SPI to pot chip. Add reset button and fuse.
    [untitled.brd, untitled.sch]
2011-11-07 Expansion headers routed. Started schematic cleanup. Added half of decoupling/filtering circuits. FET thermals and power routing done.
    [untitled.brd, untitled.sch]
2011-11-07 Added some more power filtering. Cleaned up some reverse side traces.
    [untitled.brd, untitled.sch]
2011-11-08 Added most of the buck converter circuitry (except caps and possibly filter inductor on output). Added more decoupling and rerouted analog inputs (now at left of header). Freed up space on corner of 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
    [untitled.brd, untitled.sch]
2011-11-08 Added 3.3V pre and post converter caps. Routed logic power circuitry.
    [untitled.brd, untitled.sch]
2011-11-09 Added power filtering for the sam3u's utmi and analog supplies. Added component values for all decoupling caps.
    [untitled.brd, untitled.sch]
2011-11-10 Added protection diode, 3 software controlled RGB LEDs, and indicator LEDs for USB and 12V power.
    [untitled.brd, untitled.sch]
2011-11-10 Schematic cleanup
    [untitled.brd, untitled.sch]
2011-11-10 Straighten some paths
    [untitled.brd]
2011-11-10 Add part number to diodes
    [untitled.brd, untitled.sch]
2011-11-10 Add input capacitor and silkscreen markings.
    [untitled.brd, untitled.sch]
2011-11-11 Add filter cap on USB power input
    [untitled.brd, untitled.sch]
2011-11-11 Added flash erase pads, silkscreen markings and exported image file
    [untitled.brd, untitled.sch]
2011-11-11 Move fuse holder a bit to ensure solder mask bridge between temp header and +12V
    [untitled.brd]
2011-11-14 Change solder paste profiles for components with large ground pads.
    [untitled.brd, untitled.sch]
2011-12-06 Fix footprint of 0.1" headers. Improve ground current paths. Remove thermals on high current paths.
    [untitled.brd, untitled.sch]
2011-12-07 Make mountinh holes M2 and add clearance
    [untitled.brd]
2011-12-09 Reduce number of drill sizes to 3 for cheaper manufacture.
    [untitled.brd, untitled.sch]
2011-12-19 Rotate FET, make space for endstop signal filtering.
    [untitled.brd, untitled.sch]
2011-12-20 Align 0.1" headers with each other. More space around USB data lines. More spacing around some passives. Better ground path from the drivers to the power connector. Fix silkscreen label positioning. 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
    [untitled.brd]
2011-12-26 Minor positioning tweaks
    [untitled.brd]
2011-12-29 Fix wrong footprint on SD socket. Reroute affected area. Pin changes for the RGB LEDs and SD card detect.
    [untitled.brd, untitled.sch]
2011-12-29 Add current limiting series resistors to FETs. Remove all exposed traces/vias from the SD no pattern area. Switch potentiometer supply and reference to filtered power.
    [untitled.brd, untitled.sch]
2011-12-29 Switch thermistor reference to filtered power supply.
    [untitled.brd, untitled.sch]
2011-12-30 Add pin mapping. Minor schematic cleanup.
    [untitled.brd, untitled.sch]
2011-12-30 Add bed heater pin
2012-01-01 Minor schematic and board cleanup
    [untitled.brd, untitled.sch]
2012-01-05 Reroute 3 analog pins to endstop headers (causes changes in pin mappings). Add voltage divider for VMOT detection. Reroute the SD socket to respect keepout area. Fix trace angles. Major schematic cle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
    [untitled.brd, untitled.sch]
2012-01-05 Regenerate board image.
    [untitled.brd]
2012-01-06 Move output capacitor closer to inductor on vreg. Move power input header north to make more space for bed connector. Move filter cap on power input closer to fuse.
    [untitled.brd]
2012-01-06 Update board image.
2012-01-07 Move USB F resistors closer to device pins. Minor optimization of USB path.
    [untitled.brd]
2012-01-07 Match USB trace length to within 0.12 mm (6mil)
    [untitled.brd]
2012-01-07 Updated board image to reflect changed USB routing
2012-01-08 Add extra filter cap to vcore. Add filter cap to VMOT detect.
    [untitled.brd, untitled.sch]
2012-01-10 Add i2c pullups. Update silkscreen. Update board image.
    [untitled.brd, untitled.sch]
2012-01-26 Add pullup resistors to SD data lines. Add extra decoupling to SD power. Regenerate board image.
    [untitled.brd, untitled.sch]
2012-01-29 Update board image
2012-02-08 Fix a few library footprints to have correct orientation. Enlarge pads on bed MOSFET.
    [untitled.brd, untitled.sch]
2012-02-14 Fix DRC errors according to stricter rules. Slightly extended board dimensions to ensure floating anchors are solidly attached.
    [untitled.brd, untitled.sch]
2012-03-04 Add fiducial markers to board
    [untitled.brd]
2012-03-15 Update pinmap Change input capacitor package Improve E0 heatsinking Fix bed connector package
    [untitled.brd, untitled.sch]
2012-03-15 Add BOM with sources
    [bomtable.ods]
2012-03-16 Updated board image
2012-05-20 Clean up schematic somewhat. Update footprint for USB connector and 2x7 header. Move large decoupling cap for card power. Move silkscreen texts so they are off pads. Add silkscreen below USB connecto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
    [untitled.brd, untitled.sch]
2012-07-01 Update library to have component names.
    [untitled.brd, untitled.sch]
2012-09-25 Improved readability of schematic.
    [untitled.brd, untitled.sch]
2012-09-25 Added pdf schematic
2012-09-25 Changed LED signal names to match pinmap.txt
    [untitled.brd, untitled.sch]
2013-01-29 Added BOM table that was used to order parts for production
    [11862_V04_PB.xls]
